rosmo-robot/Open-Core-M5stack/README.md

!!Untested!!

OpenCore boards for use in the M5Stack system

[Version 1](https://github.com/rosmo-robot/Open-Core-M5stack/blob/main/v1/readme.md) uses ESP32devC-v4 development board

[Version 2](https://github.com/rosmo-robot/Open-Core-M5stack/tree/main/2.2) uses on-board ESP32 chip
