rosmo-robot/Open-Core-M5stack/v3/Readme.md

A simple adaptor board to connect a [common, cheap 1.8" screen](http://www.lcdwiki.com/1.8inch_Esplora_TFT_LCD) to a feather and provide additional I2C breakouts.

Front of the board (You would be looking at the LCD screen)
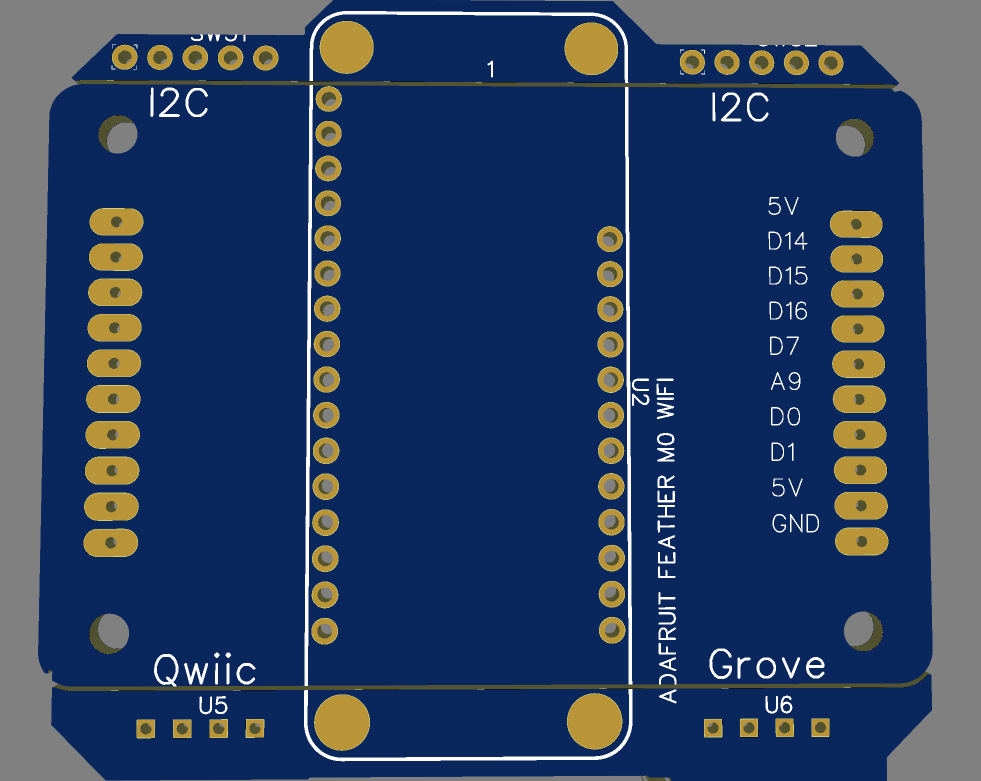
[picture p1: v3/images/feather.png]


The LCD connects to the board (pins are staggered)

The feather connects to the board (pins are staggered)

You can then use the LCD as SCK/ MOSI etc etc are all connected

Two Breakout garden I2C pin headers are provided

Pins for 1x Quiic socket are provided

Pins for 1x Grove socket are provided

You can see an example of the off-centre/staggered/not straight pins here:
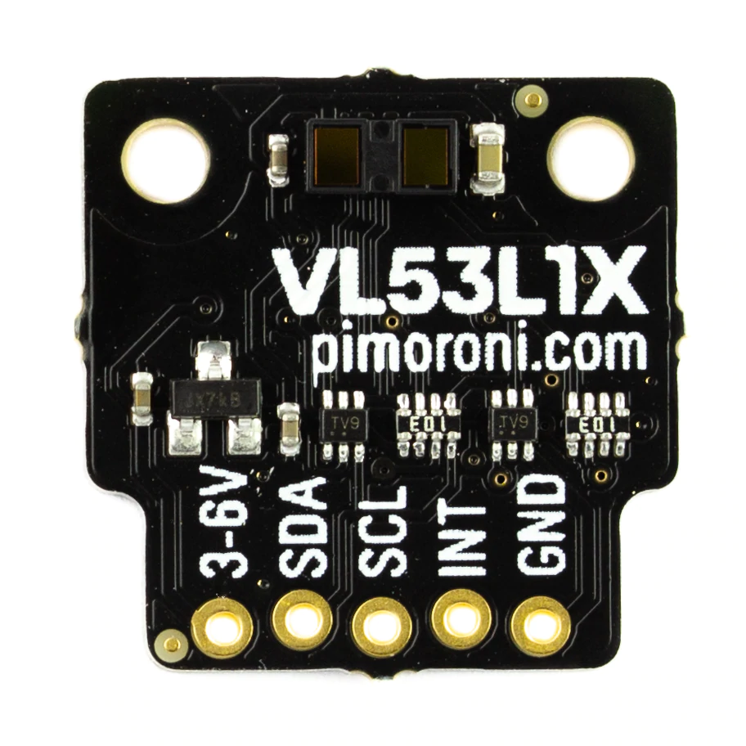
[picture p2: v3/images/pins.webp]


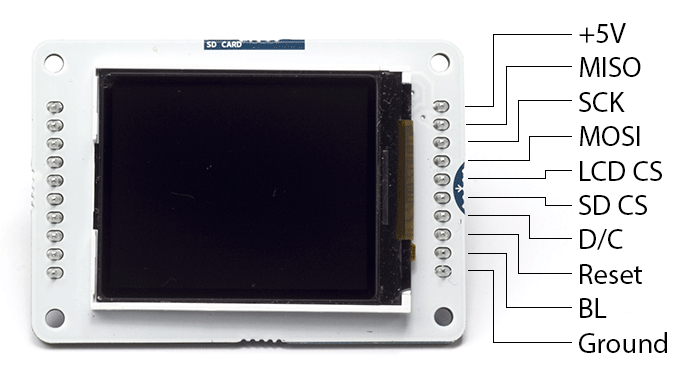
[picture p3: v3/images/GLCD_pinUse.png]


Feather to Mikrobus already exists: https://www.tindie.com/products/bokra/feather-shield/ https://www.mikroe.com/click

2x [5pin breakoutgarden I2C](https://shop.pimoroni.com/collections/breakout-garden) TOF sensors in particular

3s Lipo 71mm https://www.aliexpress.com/item/4001211447586.html
70mm https://www.aliexpress.com/item/4001054101417.html
