rosmo-robot/Open-Core-M5stack/marketing.md

- Who

Academics
Education, STEM - Otto
African OSHW community
Take each component address seperately. 
Break the parts demo BLDC seperately.

Reason for doing it - get good motor control cheaper than Odrive

- Where
Personal robotics forum
Youtube channels
ROS forum
Twitter as a robot and as a component.
=Robot 
=Open Core
=ESC
= MicroROS events

- Moments
ESC v1 DEC
Open core v1 March
3D body version 1. May
Physical v1 May
ROSMO v1 June
