rosmo-robot/Open-Core-M5stack/v3/images/front-feather.png

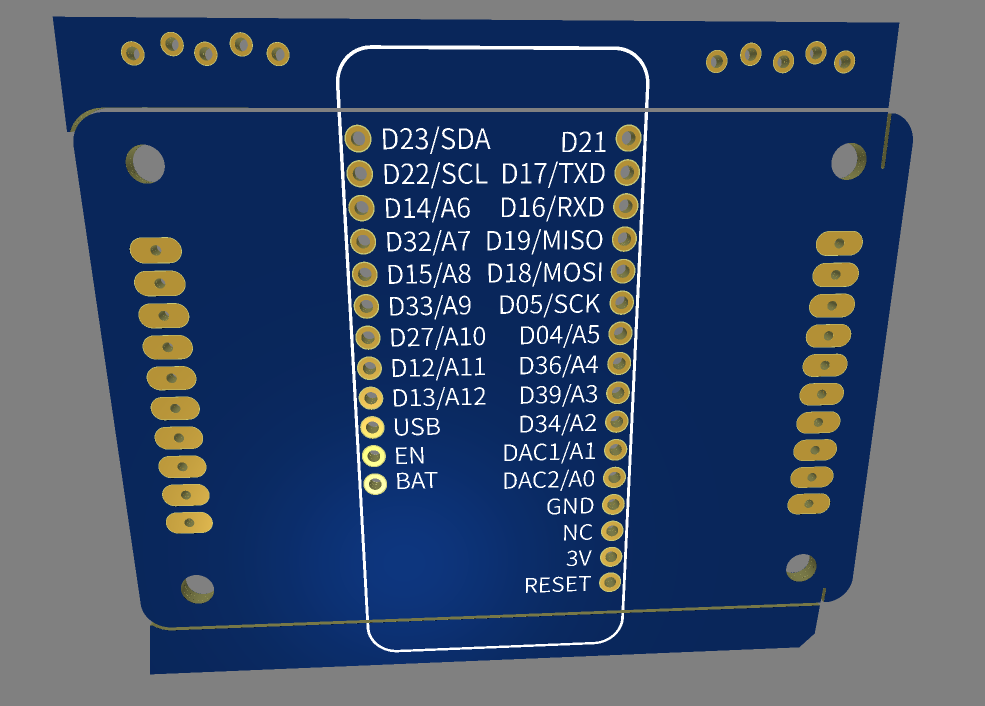
v3/images/front-feather.png
