rosmo-robot/Open-Core-M5stack/v3/images/janusbottom.png

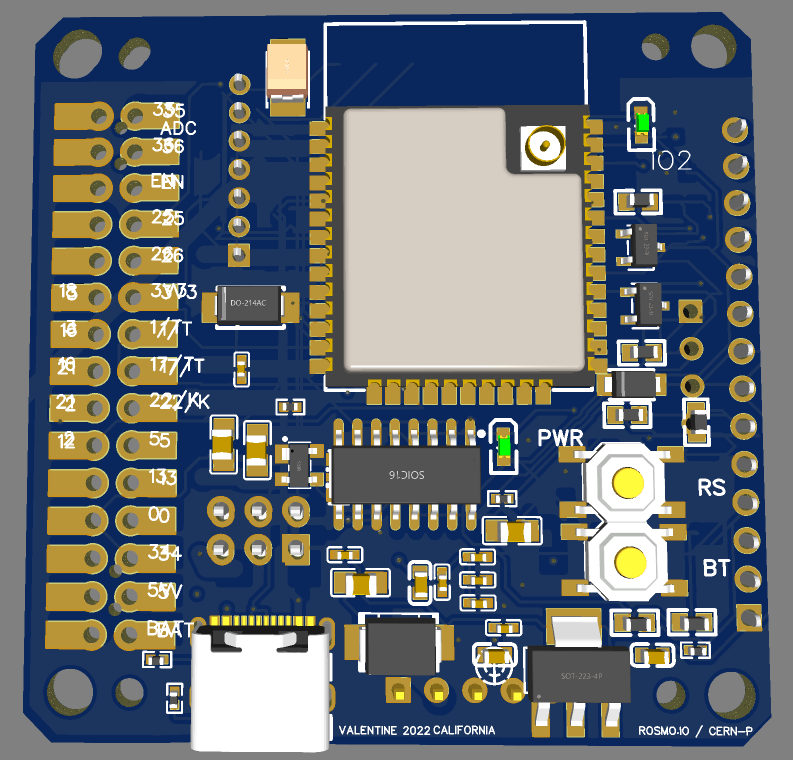
v3/images/janusbottom.png
