rosmo-robot/Open-Core-M5stack/v3/images/janustop.png

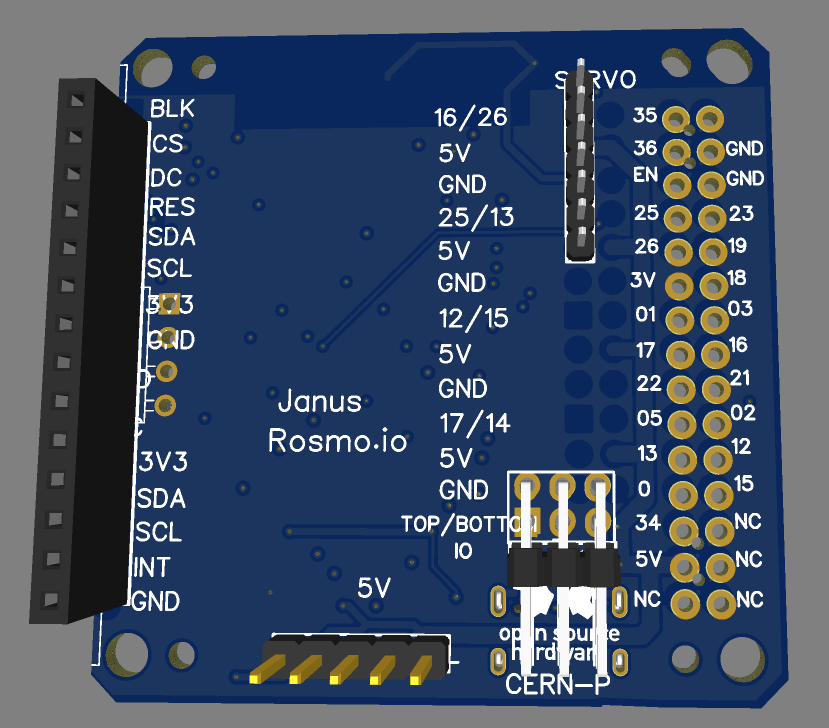
v3/images/janustop.png
