rosmo-robot/Open-Core-M5stack/v3/images/v3.01silk.png

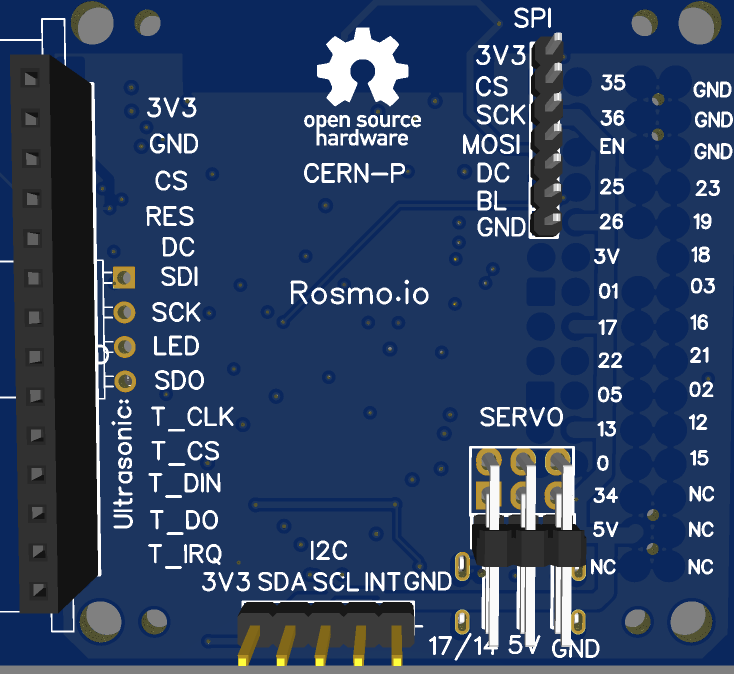
v3/images/v3.01silk.png
