rosmo-robot/Open-Core-M5stack/2.2/octocoreBOM.xlsx

Designator | Supplier Part | Quantity | Link | Manufacturer Part | Footprint | Manufacturer | Supplier | Name | description
C21,C3,C6 | C85713 | 3 | https://lcsc.com/product-detail/Multilayer-Ceramic-Capacitors-MLCC-SMD-SMT_Samsung-Electro-Mechanics-CL10A106MP8NNNC_C85713.html | CL10A106MP8NNNC | C0603 | Samsung Electro-Mechanics | LCSC | 10uF
D3 | C2836313 | 1 | https://lcsc.com/product-detail/ESD-Protection-Devices_MSKSEMI-PRTR5V0U2X-MS_C2836313.html | PRTR5V0U2X-MS | SOT-143-4_L2.9-W1.3-P1.92-LS2.4-BL | MSKSEMI(美森科) | LCSC | PRTR5V0U2X-MS
D4 | C2840959 | 1 | https://lcsc.com/product-detail/Diodes-General-Purpose_Agertech-1N4007FL_C2840959.html | 1N4007FL | SOD-123W_L2.8-W1.8-LS3.7-RD | 艾吉芯(Agertech) | LCSC | 1N4007FL_C2840959
R8 | C144807 | 1 | https://lcsc.com/product-detail/Chip-Resistor-Surface-Mount_YAGEO-AC0402FR-0710KL_C144807.html | AC0402FR-0710KL | R0402 | YAGEO | LCSC | 10K
R9,R10 | C138073 | 2 | https://lcsc.com/product-detail/Chip-Resistor-Surface-Mount_YAGEO-RC0402DR-075K1L_C138073.html | RC0402DR-075K1L | R0402 | YAGEO | LCSC | 5.1K
C1,C2,C4,C8,C18,C66,C67 | C307331 | 7 | https://lcsc.com/product-detail/Multilayer-Ceramic-Capacitors-MLCC-SMD-SMT_Samsung-Electro-Mechanics-CL05B104KB54PNC_C307331.html | CL05B104KB54PNC | C0402 | Samsung Electro-Mechanics | LCSC | 100nF
U2 | C6186 | 1 | https://lcsc.com/product-detail/Linear-Voltage-Regulators-LDO_Advanced-Monolithic-Systems-AMS1117-3-3_C6186.html | AMS1117-3.3 | SOT-223-3_L6.5-W3.4-P2.30-LS7.0-BR | AMS | LCSC | AMS1117-3.3
BOOT1,RST1 | C318884 | 2 | https://lcsc.com/product-detail/Tactile-Switches_XKB-Connectivity-TS-1187A-B-A-B_C318884.html | TS-1187A-B-A-B | SW-SMD_4P-L5.1-W5.1-P3.70-LS6.5-TL-2 | XKB Enterprise | LCSC | TS-1187A-B-A-B
R1,R2,R6,R7 | C43113 | 4 | https://lcsc.com/product-detail/NTC-Thermistors_Sunlord-SDNT1608X103J3450HTF_C43113.html | SDNT1608X103J3450HTF | R0603 | Sunlord | LCSC | 10k
R3,R4 | C177612 | 2 | https://lcsc.com/product-detail/Chip-Resistor-Surface-Mount_HKR-Hong-Kong-Resistors-RCT03470KFLF_C177612.html | RCT03470KFLF | R0603 | HKR | LCSC | 470
Q1,Q3 | C2146 | 2 | https://lcsc.com/product-detail/Bipolar-Transistors-BJT_Changjiang-Electronics-Tech-CJ-S8050-J3Y_C2146.html | S8050 | SOT-23-3_L3.0-W1.7-P0.95-LS2.9-BR | CJ | LCSC | S8050_C2146
C5 | C16133 | 1 | https://lcsc.com/product-detail/Tantalum-Capacitors_AVX-TAJB107K006RNJ_C16133.html | TAJB107K006RNJ | CAP-SMD_L3.5-W2.8 | AVX | LCSC | 100uF
D1 | C8678 | 1 | https://lcsc.com/product-detail/Schottky-Barrier-Diodes-SBD_MDD-Microdiode-Electronics-SS34_C8678.html | SS34 | DO-214AC_L4.3-W2.7-LS5.3-RD | MDD | LCSC | SS34_C8678
C19,C20,C10,C11,C12,C14,C15,C16,C17,C13 | C440198 | 10 | https://lcsc.com/product-detail/Multilayer-Ceramic-Capacitors-MLCC-SMD-SMT_Murata-Electronics-GRM21BR61H106KE43L_C440198.html | GRM21BR61H106KE43L | C0805 | Murata Electronics | LCSC | 10uF
D2 | C78395 | 1 | https://lcsc.com/product-detail/TVS_Brightking-Elec-TAIWAN-P6SMB6-8CA_C78395.html | P6SMB6.8CA | SMB_L4.6-W3.6-LS5.3-BI | Brightking | LCSC | P6SMB6.8CA-C78395
LED1RED | C118339 | 1 | https://lcsc.com/product-detail/Light-Emitting-Diodes-LED_ARKLED-Wuxi-ARK-Tech-Elec-D-060306B1_C118339.html | D-B060306B1-KS2 | LED0603-R-RD | Wuxi ARK Tech Elec | LCSC | KT-0603R
R5,R23 | C25900 | 2 | https://lcsc.com/product-detail/Chip-Resistor-Surface-Mount_UNI-ROYAL-Uniroyal-Elec-0402WGF4701TCE_C25900.html | 0402WGF4701TCE | R0402 | UniOhm | LCSC | 4.7K
LED2GREEN | C72043 | 1 | https://lcsc.com/product-detail/Light-Emitting-Diodes-LED_Everlight-Elec-19-217-GHC-YR1S2-3T_C72043.html | 19-217/GHC-YR1S2/3T | LED0603-R-RD | EVERLIGHT | LCSC | 19-217/GHC-YR1S2/3T
U1 | C14267 | 1 | https://lcsc.com/product-detail/USB-ICs_WCH-Jiangsu-Qin-Heng-CH340G_C14267.html | CH340G | SOIC-16_L9.9-W3.9-P1.27-LS6.0-BL | WCH | LCSC | CH340G
X1 | C341520 | 1 | https://lcsc.com/product-detail/Ceramic-Resonators_Murata-Electronics-CSTNE12M0G550000R0_C341520.html | CSTNE12M0G550000R0 | CRYSTAL-SMD_3P-L3.2-W1.3-P1.2-L | Murata Electronics | LCSC | 12MHz
USBC1 | C136423 | 1 | https://lcsc.com/product-detail/USB-Connectors_SOFNG-MC-311D_C136423.html | MC-311D | USB-C-SMD_MC-311D | SOFNG | LCSC | MC-311D
5V | C20079 | 1 | https://lcsc.com/product-detail/Wire-To-Board-Wire-To-Wire-Connector_BOOMELE-Boom-Precision-Elec-XH-2A_C20079.html | XH-2A | CONN-TH_XH-2A | BOOMELE | LCSC | XH-2A
H1 | 5330-M5CONN2X15F | 1 | https://shop.m5stack.com/products/2x15-pin-headers-socket | 5330-M5CONN2X15F | M5_CUSTOM_B | M5 Stack | https://www.futurashop.it/ | M5STACK BOARD-VRL-3
J1 | C358687 | 1 | https://lcsc.com/product-detail/Pin-Headers_MINTRON-MTP125-1105S1_C358687.html |  | HDR-M-2.54_1X5 |  | LCSC | I2C
LCD1 | C2905417 | 1 | https://lcsc.com/product-detail/Female-Headers_Shenzhen-Kinghelm-Elec-KH-2-54FH-1X8P-H8-5_C2905417.html |  | HDR-M-2.54_1X8 |  | LCSC | HDR-M-2.54_1x8
S34,S56,S78, S12 | C239334 | 4 | https://lcsc.com/product-detail/Pin-Headers_CJT-Changjiang-Connectors-A2541WR-2x3P_C239334.html |  | HDR-M-2.54_2X3 | Changjiang Connectors | LCSC | HDR-M-2.54_2x3
U3 | C328062 | 1 | https://lcsc.com/product-detail/WiFi-Modules_Espressif-Systems-ESP32-WROOM-32U_C328062.html | ESP32-WROOM-32U | WIFIM-SMD_39P-L25.5-W18.0-P1.27-BL | ESPRESSIF 乐鑫 | LCSC | ESP32-WROOM-32U
