rosmo-robot/Open-Core-M5stack/v1/esp32 m5 shield.pdf

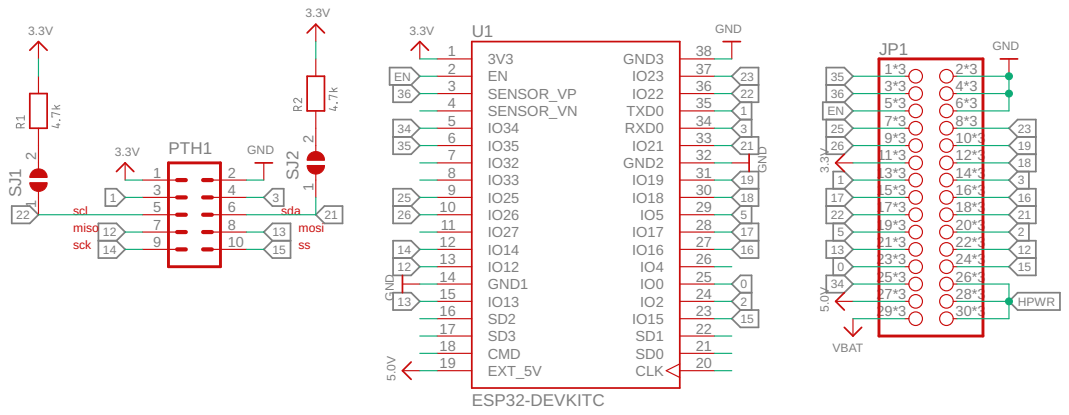
[picture p13: page 1]
