rosmo-robot/Open-Core-M5stack/v1/esp32 m5 shield.brd

## EAGLE design v1/esp32 m5 shield.brd (2022-01-04, an earlier design)

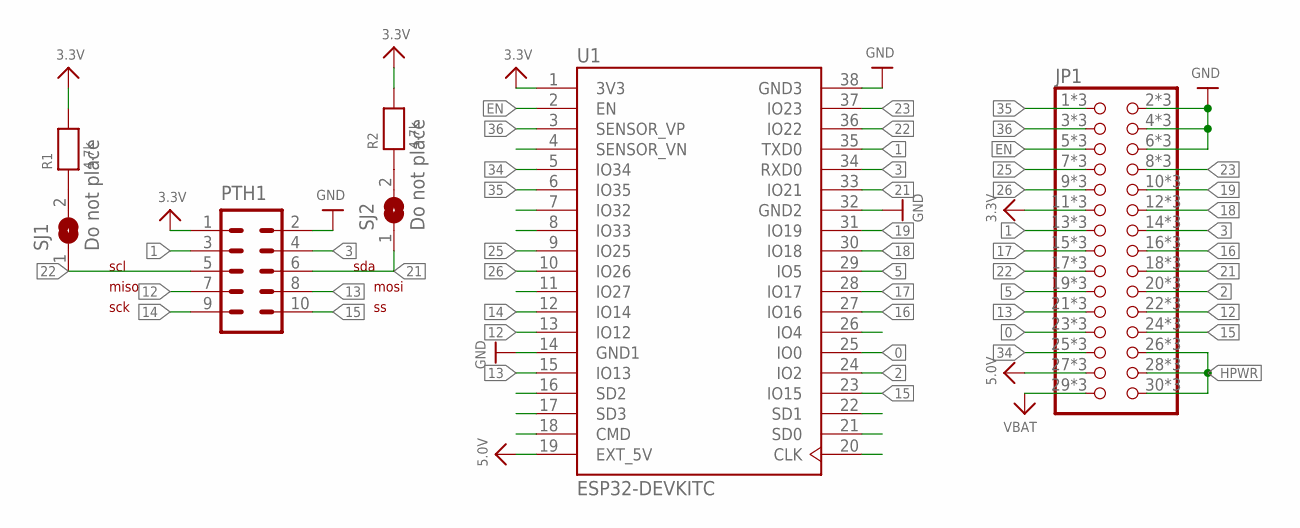
[picture p14: schematic esp32 m5 shield.sch]

Parts:
JP1: PINHD-2X15; 2X15
PTH1: ML10PTH; ML10-MALE
R1, R2: 4.7k; 0603-MINI
SJ1, SJ2: Do not place; SOLDERJUMPER_CLOSEDWIRE
U1: ESP32-DEVKITC; MODULE_ESP32-DEVKITC

Connections:
0: JP1.23, JP1.P$23 (23), JP1.P$53 (23), U1.25 (IO0)
1: JP1.13, JP1.P$13 (13), JP1.P$43 (13), PTH1.3, U1.35 (TXD0)
2: JP1.20, JP1.P$20 (20), JP1.P$50 (20), U1.24 (IO2)
3: JP1.14, JP1.P$14 (14), JP1.P$44 (14), PTH1.4, U1.34 (RXD0)
3.3V: JP1.11, JP1.P$11 (11), JP1.P$41 (11), PTH1.1, R1.2, R2.2, U1.1 (3V3)
5: JP1.19, JP1.P$19 (19), JP1.P$49 (19), U1.29 (IO5)
5.0V: JP1.27, JP1.P$27 (27), JP1.P$57 (27), U1.19 (EXT_5V)
12: JP1.22, JP1.P$22 (22), JP1.P$52 (22), PTH1.7, U1.13 (IO12)
13: JP1.21, JP1.P$21 (21), JP1.P$51 (21), PTH1.8, U1.15 (IO13)
14: PTH1.9, U1.12 (IO14)
15: JP1.24, JP1.P$24 (24), JP1.P$54 (24), PTH1.10, U1.23 (IO15)
16: JP1.16, JP1.P$16 (16), JP1.P$46 (16), U1.27 (IO16)
17: JP1.15, JP1.P$15 (15), JP1.P$45 (15), U1.28 (IO17)
18: JP1.12, JP1.P$12 (12), JP1.P$42 (12), U1.30 (IO18)
19: JP1.10, JP1.P$10 (10), JP1.P$40 (10), U1.31 (IO19)
21: JP1.18, JP1.P$18 (18), JP1.P$48 (18), PTH1.6, SJ2.1, U1.33 (IO21)
22: JP1.17, JP1.P$17 (17), JP1.P$47 (17), PTH1.5, SJ1.1, U1.36 (IO22)
23: JP1.8, JP1.P$8 (8), JP1.P$38 (8), U1.37 (IO23)
25: JP1.7, JP1.P$7 (7), JP1.P$37 (7), U1.9 (IO25)
26: JP1.9, JP1.P$9 (9), JP1.P$39 (9), U1.10 (IO26)
34: JP1.25, JP1.P$25 (25), JP1.P$55 (25), U1.5 (IO34)
35: JP1.1, JP1.P$1 (1), JP1.P$31 (1), U1.6 (IO35)
36: JP1.3, JP1.P$3 (3), JP1.P$33 (3), U1.3 (SENSOR_VP)
EN: JP1.5, JP1.P$5 (5), JP1.P$35 (5), U1.2 (EN)
GND: JP1.2, JP1.4, JP1.6, JP1.P$2 (2), JP1.P$4 (4), JP1.P$6 (6), JP1.P$32 (2), JP1.P$34 (4), JP1.P$36 (6), PTH1.2, U1.14 (GND1), U1.32 (GND2), U1.38 (GND3)
HPWR: JP1.26, JP1.28, JP1.30, JP1.P$26 (26), JP1.P$28 (28), JP1.P$30 (30), JP1.P$56 (26), JP1.P$58 (28), JP1.P$60 (30)
unnamed: R1.1, SJ1.2
unnamed: R2.1, SJ2.2
VBAT: JP1.29, JP1.P$29 (29), JP1.P$59 (29)

Notes on the sheet:
mosi
miso
sda
scl
sck

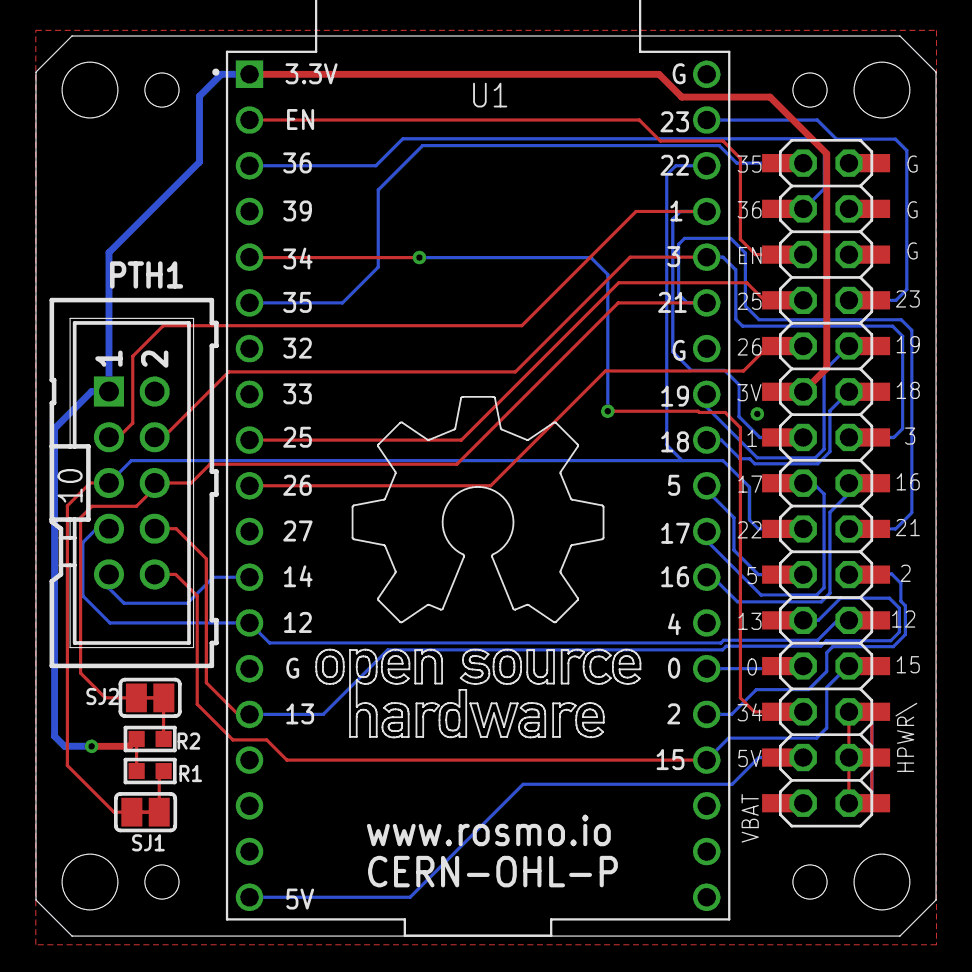
[picture p15: board esp32 m5 shield.brd from above]

Board: 2 copper layers, 50.0 x 50.0 mm, 7 parts (0 on the bottom side), 29 nets.
