rosmo-robot/Open-Core-M5stack/(threads)

Thread 1 (2022-01-04):

Review ESP32 adaptor board

samuk, 2022-01-04:
Does this seem like it would work?

runger1101001, 2022-01-04:
Another comment: I see that most of the m5 header pins are not connected. But if this is to be a replacement open core board for m5 stack, all the ESP32 pins should be connected to the corresponding m5 header pins, or it won't be compatible with the standard core and the other modules...

samuk, 2022-01-04:
Thanks, I uploaded it here without really checking it. I think we're missing the whole bottom layer. I'll get back to the guy and see if he can export again/resolve.

samuk, 2022-01-04:
If you open the .brd file in Fusion360 you can see the bottom layer. I can't get it very clear, but I don't know 360 really.

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

samuk, 2022-01-05:
"Did you cross-check the pins used against the ESP32's flash pins? It has a bunch of pins you can't really use, or only after boot-up is complete. It's usually a mistake to connect things to these pins, it can prevent the ESP32 booting."

esp32 flash pins are gpio 1 and 3 and those pins are connected with both m5 connector and uext connector

Would you recommend disconnecting them and choosing some alternates for GPIO?

runger1101001, 2022-01-07:
Hey, the new picture looks much better for the header connections.

Now I have the following points:
- I'd say its usual for nCS lines to have pull-ups...
- I'm still quite confused around the M5 power concept. In this configuration, the MCU boards 5V, wherever it comes from, would power the stack, or the stack would power the 5V. But the 3.3V is also connected, so the MCU board's 3.3V regulator will power that. What if another module applies power to this pin? These topics are pretty hairy, you can take a look at some of the recent Arduino MCUs to see how they solve it with their VIN, 3.3V and 5V rails... they have a bunch of mosfets (as ideal diodes) and transistors to sense/switch the power paths. Is it necessary? I don't know. Depends how the different components involved handle being back-powered...
- VBAT is unconnected, so the open-core won't support battery power/charging like the normal core does...

Flash pins: are GPIOs 6,7,8,9,10,11 - these pins should not be used, really, but it looks like they aren't exposed on the MCU board anyway, so all good there. Pins 1,3 are the default UART, you can use those.

samuk, 2022-01-07:
Comments from developer
"you don't have to worry about those 3.3v and vin/5v.

as long as you are using 3.3v in that 3.3v pin it will be fine (input or output). as esp32 dev board already have a voltage regulator inside. But you have to supply 5 v or more in the vin pin .

I checked those arduino mcu vin 3.3v and 5 v rail. those are same as esp32 dev board one.

and you will not need any mosfet or diode for sense or switch. (i tested that myself in my some other pcb) . you will need that if you want to keep esp32 powered by battery and also charge the battey using vin."

ShouravSarkar, 2022-01-07:
Hi there.
vbat pin is exposed because there is not connection pin for battery from esp32 dev board. we can still use vbat but we have to make separate circuit for that which will power the board and also charge the battery from the VIN supply.

there are some board like adafruit esp32 board which is open source  and they break out the vbat pin

runger1101001, 2022-01-07:
Much as I like the Adafruit products, I think that would make the whole thing more expensive... and specific to a vendor/board. As far as I know there are quite a few of the DevKit type boards out there, presumably most with compatible pinouts?
So I think that is actually a good choice.

I'll trust you on the power concept ;-) if you say you've tried it out in the past, that's what's most important.

Maybe a solution for the VBAT is to use an existing battery-charger/boost converter board - there are many on aliexpress... or make the decision to keep it as it is, and open-core just doesn't do the battery charging...
For Rosmo, there needs to be a different charging concept for its 3 LiFe batteries anyway...

ShouravSarkar, 2022-01-07:
can you tell me one thing? you are going to power the board using vin . right? and 3.3v will be output for other sensors that use 3.3 v. right?

for battery charging you can use those  aliexpress module. but it is better to integrate so single vin will power everything

runger1101001, 2022-01-07:
Hey, when you say "the board", you mean the DevKit MCU board? I guess that's up to you, depending on your design for the open core board...

AFAICT the power concept for M5 stack seems to be mainly the 5V line, which either powers the core or is powered by the core. There's also the VBAT pin, which is expected to be powered by a Lion/LiPo 3.7V 1S cell. This pin either powers the m5 core, and via it the 5V line of the m5 stack, or it is powered by the m5 core's built-in charger, when the m5 core is plugged into USB.
VUSB isn't exposed unfortunately, so you can't charge the battery from another source.

The 3.3V line can be used to power 3.3V peripherals/modules, we'll use it to power the prototype ESC board when not connected to USB.

ShouravSarkar, 2022-01-08:
yes.

as your description, this PCB will be okay.

only thing is the battery now. if you want to use battery then we have to use another battery charging circuit and also some mosfet diode etc

samuk, 2022-01-08:
I think the board as it stands works for our use case? Just to re-state to check my understanding:

- ~12v will be provided to the ESC to drive the motors
- An external 12v>5v buck will provide 5v to the ESC USB. This will power the M5stack Mbus 5v line.
- The Open core board discussed here will connect to the 5v-M5stack-Mbus-pin, which will power the board.

Is that correct?

For use cases beyond this, where people want to use a 3.7v Lipo, can they not use the [ESP32-Olimex-Lipo-board](https://www.olimex.com/Products/IoT/ESP32/ESP32-DevKit-LiPo/resources/ESP32-DevKit-Lipo-GPIOs.png) and connect the Lipo directly to the ESP32-Olimex-Lipo-board? So long as they then apply 5v to the 5v-M5stack-Mbus-pin for charging, the ESP32 on-board circuit should handle the charging?

ShouravSarkar, 2022-01-08:
For use cases beyond this, where people want to use a 3.7v Lipo, can they not use the ESP32-Olimex-Lipo-board and connect the Lipo directly to the ESP32-Olimex-Lipo-board?

yes. If they connect battery with esp32 board it will work perfectly and it will charge when 5v apply to m5 stack

samuk, 2022-01-11:
This issue has served its purpose, check other issues in the queue.

Closed 2022-01-11.

Thread 2 (2022-01-08):

SMD > through-hole resistors & Create BOM for Open core

samuk, 2022-01-08:
Header pins etc.

samuk, 2022-01-08:
@ShouravSarkar could you provide a BOM? I had a look at it by loading the .brd file in Kicad, but couldn't work it out.

ShouravSarkar, 2022-01-08:
I already provided I think. okay I can provide again.

runger1101001, 2022-01-09:
IIRC you only have 2 resistors on there, plus the headers. And the m5 bus header is only going in one direction.

How about replacing the SMD resistors with small through-hole models, then the whole board will use only THT components?
Then I would produce this board without any assembly for $5 at PCBWay, or $2 at JLCPCB... Hand-soldering those few through hole components won't be hard...

ShouravSarkar, 2022-01-12:
okay I can change that smd with through hole

ShouravSarkar, 2022-01-12:
should I do that ?

samuk, 2022-01-12:
Yes please!

 These are part number for the m5 header https://store.open-electronics.org/2x15-Pin-Headers-Socket-2,54mm-Male-Connector-5330-M5CONN2X15M

ShouravSarkar, 2022-01-12:
ok you can use this header pin with current design

runger1101001, 2022-01-12:
Careful! That's a male header, and the core board needs a female one...
but it doesn't matter, the footprint supports both THT and SMD headers, and male/female have the same footprint, so no need to change the layout. It's just a BOM question.

samuk, 2022-01-12:
Sorry this is the female: https://www.futurashop.it/connettore-per-m5stack-2x15pin-femmina-5330-m5conn2x15f?search=M5CONN

Could you move the resistors to the centre of the board, underneath the ESP32. Please could you also add silkscreen with the part number/spec. The use case here is if it's your first ever attempt at soldering.

Closed 2022-01-21.

Thread 3 (2022-01-08):

Create populated 3D model & .step file of open core board

samuk, 2022-01-08:
Would be good to get a 3D model with the headers/UEXT/[Grove?](https://github.com/rosmo-robot/Open-Core-M5stack/issues/5) & ESP32devCv4 board as 3D parts. The board should be white, with black silkscreen & including version number 0.1v on the silkscreen. To then export this to Online viewers

& create .STEP file to enable https://github.com/rosmo-robot/Rosmo_3D/issues/4

ShouravSarkar, 2022-01-12:
yes. It is possible to do that. but it will cost some more design cost also

samuk, 2022-01-12:
Ok, no worries.

Closed 2022-01-12.

Thread 4 (2022-01-09):

V2 ESP32 dev board compatible with; M5stack, Stemma, OLED

samuk, 2022-01-09:
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

Very rough sketch of CERN licenced [ESP32 board](https://easyeda.com/editor#id=0c94645e6c4e443cb9d172e18162d7fa) in 5cm x 5cm M5stack dimensions.

- 8x servo for a walking otto as [Robo8080 documents](https://togetter.com/li/1374900)
- 5v input via JST
-  Optional [HCS404](https://github.com/rosmo-robot/Rosmo_3D/issues/6) staggered pins
- Optional [M5 Mbus](https://forum.m5stack.com/topic/360/m5stack-fire-pinout-leaflet)
- Optional [ staggered 7pin display 1.44](https://www.aliexpress.com/item/1005001636544551.html)
- Optional [3v Stemma](https://www.tomshardware.com/features/stemma-vs-qwiic-vs-grove-connectors) Supports [Qwiic](https://www.reddit.com/r/electronics/comments/8lhxwg/sparkfuns_qwiic_standard_for_modular_i2c_devices/), [Grove (I2C)](https://thepihut.com/products/qwiic-cable-grove-adapter-100mm) ,[Gravity](https://learn.adafruit.com/introducing-adafruit-stemma-qt/dfrobot-gravity)

**Use cases might include:**

**Rosmo**
https://rosmo.io

**Rosmo with micro servo**
Driven just by Open Core and [ 2x continuous rotation micro servo](https://kitronik.co.uk/products/2589-fs90r-360-degree-continuous-rotation-servo) instead of BLDC. These could fit in the existing BLDC socket with a 3d printed adaptor

**Otto DIY**
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

Otto Ninja is 4cm x 4cm internally

**Notes**
Nice ['snap' proto board here](https://twitter.com/CRImierTech/status/1481676889353773059)

Breakout garden [style pins](https://www.aliexpress.com/item/1005003003362076.html)

**1.44" & 1.8 Sureno fit in footprint ST7735  https://www.aliexpress.com/item/32913241143.html  [supported](https://github.com/Bodmer/TFT_eSPI)**  29.70x43.36(mm) http://www.lcdwiki.com/1.44inch_SPI_Module_ST7735S_SKU:MSP1443
<html>
<body>
<!--StartFragment-->

1 | VCC | 5V/3.3V power input
-- | -- | --
2 | GND | Ground
3 | CS | LCD chip select signal, low level enable
4 | RESET | LCD reset signal, low level reset
5 | A0 | LCD register / data selection signal,high level: register, low level: data
6 | SDA | SPI bus write data signal
7 | SCK | SPI bus clock signal
8 | LED | Backlight control, high level lighting,if not controlled, connect 3.3V always bright

<!--EndFragment-->
</body>
</html>

runger1101001, 2022-01-11:
In my mind, this mixes up different concepts:

- in m5 stack, there are cores and modules. the open-core is a core, but the servo and sonar stuff should be on a module.
- on the other hand if you want a minimal cost board for robots, then we could drop the m5 stack support (which complicates things and costs $$$) and make a specific board for that. But honestly I see this niche well served by a huge host of cheap boards available on AliExpress, see designs like Osmo, Zerobot etc...

Putting it all together runs the risk of producing some kind of franken-core, not properly compatible with m5 concepts, but also not ideal as a basic robot board

samuk, 2022-01-11:
I take your point.

It's driven by interest from @ottodiy. If we can support their use case well then they might help with the distribution/ development of the board. I guess I hope it could be a board that sees you through a robotics journey

1) Get a Rosmo/ Otto wheeled moving about on continuous micro servo & Blockly
2) Invest a bit more & make a walking Otto
3) Invest a bit more and add an official M5 stack motor driver
3) Invest a bit more Add a RosmoESC(s) to give better motor control

runger1101001, 2022-01-11:
Ah, I see! I'll make the observation that Ottos head looks a bit like an m5 stack in shape... :-)

Closed 2022-01-27.

Thread 5 (2022-01-09):

Add additional grove socket?

samuk, 2022-01-09:
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

How much of a nightmare would it be to add an additional grove socket in that top left position? We don't need it for our use case, but might make the board more useful generally.

runger1101001, 2022-01-10:
I think the pull-ups could easily be moved to make space. They can go under the dev-kit board, for example.

Note that I just heard back from PCBWay that the Grove connectors are sold out.

samuk, 2022-01-10:
Great, let's see if @ShouravSarkar has any enthusiasm to do it.

Presumably, we could design it into the board, but leave it unpopulated in a first run?

ShouravSarkar, 2022-01-12:
ok can you tell me what to update in a single details?

samuk, 2022-01-12:
Had a change of plan on this one. Please include a https://www.sparkfun.com/qwiic  (see FAQ at the bottom for spec)

Thread 8 (2022-01-11):

Support 9v input?

samuk, 2022-01-11:
With an [ams117](https://www.google.com/search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) and [JST socket](https://store.ottodiy.com/product/otto-nano-pcb-microcontroller-programmable-board-brain/)

samuk, 2022-01-11:
No need

Closed 2022-01-11.

Thread 9 (2022-01-12):

Add prototyping space

samuk, 2022-01-12:
If we re-rerouted the trace from pin 15 we could provide some onboard prototyping space, [similar to Feather](https://coolcomponents.co.uk/collections/adafruit-feather/products/feather-m0-basic-proto-atsamd21-cortex-m0)

- The area between pin [17 and pin 27](https://github.com/rosmo-robot/Open-Core-M5stack/raw/main/OpenCoreReview.png) down to the 'bottom' 5v could be perforated.

- All the pins in that bottom section could have solder-able pads put next to them for connecting to those pins

runger1101001, 2022-01-12:
I like this idea. The manufacturing cost is 0$, but the benefit to the user is large :-)

Thread 10 (2023-01-18):

Not an Issue Just an Enquery

chuck808, 2023-01-18:
Hi Guys,

Excellent work and thank you for sharing.

Although I have designed a couple of custom ESP32 boards for an ongoing project, one of the major issues, as I'm sure you are aware, is finding suitable project cases/boxes for the finished article. 3D printing is an option for a few units, but to be honest they can be slow to make and butt ugly, on the other hand, unless you are making many thousands, having them manufactures can be extremely expensive.

Another option would be to use an existing form factor like the M5Stack. So my question is, would I be able to use your design with a case like the one found [here](https://shop.m5stack.com/collections/m5-accessories/products/development-board-watch-kit-excluding-core).

Thank you in advance.

runger1101001, 2023-01-18:
Hey,

Making good cases is hard, agreed!

For a small series, 3D printing is a good option, in my opinion. You can also order small batches 3D printed at acceptable prototyping costs.
Of course compared to the unit costs of a large volume production based on plastic injection or something like that, the prototype costs for 3D printing are very high.

Using a ready-made case would be great, but this won't work, unfortunately, because the OpenStack core only has compatibility with the M5 Bus header, but it doesn't follow the M5 Core's placement of any of the other ports, so it won't work in a M5 Core case...

Some ideas:

Acrylic can be easy to work with, and can be laser-cut (which unlike 3D printing is fast and can produce elegant looking results). Many maker type cases are based on acrylic, which is available in many colours and thicknesses, and can even be ordered pre-formed in angles, circles or boxes.
With a bit of care it can be drilled or also engraved. It's easy to glue with acrylic glue, and many maker-type cases are based on it. With a couple of drilled holes you can bolt your PCBs to the base, and with the laser-cutter you can cut out openings for ports and cables...

PCBs themselves can be used as part of the case - design them in the right shape to cover and protect the actual PCBs which get sandwiched in-between. You can use standoffs to interconnect the stacks of interior PCBs, and have a bolt/screw at the outside ends. Or you can just use standard headers to interconnect, and outside bolts on the case.

Ot design your PCBs to an available case format. By using things like RPi, Arduino or M5 Stack formats, you will find plenty of ready-made cases to use.
But unfortunately this module does not allow it.
