rosmo-robot/Open-Core-M5stack/(commit log)

2022-01-04 Added first version for review
    [esp32 m5 shield.brd, esp32 m5 shield.sch]
2022-01-09 Update README.md
    de-crappified a bit
2022-01-21 Version with through hole resistors
    [bom.xlsx]
2022-01-21 Added links to parts
    [bom.xlsx]
2022-01-27 Add files via upload
    Added v1 gerber
2022-01-27 v1.0 BOM
    [bomopencorev1.xlsx]
2022-01-27 Added v1 files
    [esp32 m5 shield.brd, esp32 m5 shield.sch]
2022-01-27 Tidy, provisional BOM
2022-02-01 Update schematic
2022-02-06 Silkscreen changes
2022-04-20 BOM files as ordered
    [octocoreBOM.csv, octocoreBOM.xlsx]
2022-05-08 Gerber & EasyEDA files
2022-05-08 Same as v2.1
    [octocoreBOM.xlsx]
2022-05-08 Delete Gerber_NEW_PCB copy(LCD flip) copy.zip
    fixing silkscreen
2022-05-08 Gerber with correct LCD pins & Silkscreen
2022-05-25 Seed studio format with links
    [octocoreBOM.xlsx]
