rosmo-robot/Open-Core-M5stack/(notices)

Notices in the files:
v1/esp32 m5 shield.brd:
CERN-OHL-P
parts and their libraries:
microbuilder: This work is placed in the public domain, and may be freely used for commercial and non-commercial work with the following conditions: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
